0YXS0/YXS-FOC/2312S减速电机BOM表.xlsx

Sheet: 3D打印件
3D打印件
部件类型 | 打印材质(以嘉立创3D打印为例) | 单价(元) | 数量 | 总价(元) | 备注
摆线轮 | 树脂(9600) | 1.90 | 2 | 3.80 | 使用其他材料打印可能出现,无法顺利转动的情况,推荐使用CNC精度更高(3D打印请使用STL格式文件，CNC使用STEP格式文件)
电机输出 | 尼龙(3201PA-F) | 5.50 | 1 | 5.50 | 该部件紧贴电机,电机大力矩输出时发热比较大,故使用耐热性更好的尼龙打印
减速器外壳 | 树脂(9600) | 5.75 | 1 | 5.75
上盖 | 树脂(9600) | 2.71 | 1 | 2.71
输出下轴 | 树脂(9600) | 1.90 | 1 | 1.90
输出轴 | 树脂(9600) | 1.90 | 1 | 1.90 | 最终的承力部件,若希望有更好的机械性能可使用尼龙打印
中心输出轴 | 树脂(9600) | 1.90 | 1 | 1.90
底板 | 尼龙(3201PA-F) | 5.50 | 1 | 5.50 | 该部件和PCB底板二选一即可
总计 |  |  | 9 | 28.96 | 快递费用未计入其中

Sheet: 机械部件
机械部件
部件类型 | 尺寸(mm) | 单价(元) | 数量 | 总价(元) | 购买连接 | 备注
滚珠轴承 | 内8外14厚4 | 1.200 | 1 | 1.200 | http://e.tb.cn/h.gwAezqYSflOik1f?tk=RNxr3Nfsyd5
滚珠轴承 | 内17外23厚4 | 2.000 | 1 | 2.000 | http://e.tb.cn/h.gwAezqYSflOik1f?tk=RNxr3Nfsyd6
滚珠轴承 | 内6外10厚3 | 1.200 | 2 | 2.400 | http://e.tb.cn/h.gwAezqYSflOik1f?tk=RNxr3Nfsyd7
滚珠轴承 | 内20外25厚4 | 6.000 | 1 | 6.000 | http://e.tb.cn/h.gDXFbnwdLOXjEyB?tk=yNgH3NftFau
平面轴承 | 内3外8厚3.5 | 1.450 | 1 | 1.450 | http://e.tb.cn/h.gDAGYxVDCCutdY5?tk=1JH03NfEPaf
预埋螺母 | 内M2外3.2高8 | 0.126 | 3 | 0.378 | http://e.tb.cn/h.gD20d1XfinrMQWy?tk=1Kib3Nfzbb4 | 6.3元50个
预埋螺母 | 内M2.5外3.5高3 | 0.048 | 6 | 0.288 | http://e.tb.cn/h.gwAOoIkBYJf77n9?tk=GZgo3NUYhYO | 1.44元30个
销钉 | M2*12 | 0.038 | 5 | 0.190 | http://e.tb.cn/h.gD2TEVjGOG2dwrO?tk=c1tn3NU5gqG | 1.61元100个
销钉 | M3*10 | 0.070 | 15 | 1.050 | http://e.tb.cn/h.gD2TEVjGOG2dwrO?tk=c1tn3NU6gqG | 1.34元50个
销钉 | M1*14 | 0.032 | 2 | 0.064 | http://e.tb.cn/h.gD2TEVjGOG2dwrO?tk=c1tn3NU7gqG | 1.61元100个
垫片 | M2*6*0.5 | 0.014 | 15 | 0.217 | http://e.tb.cn/h.gxa4c33pDSauiBj?tk=GuPI3NU540g | 2.89元200个
螺丝 | M2.5*20*4.5 | 0.067 | 6 | 0.400 | http://e.tb.cn/h.T2p2wnHFBUwPk0t?tk=4aWF3uRsDdy | 2.24元50个
内六角螺丝 | M3*5*5 | 0.020 | 2 | 0.041 | http://e.tb.cn/h.gwAwCQvNh4fQR93?tk=WvMC3NU8SnZ | 2.03元100个
螺丝 | M2*3*3.2 | 0.012 | 3 | 0.035 | http://e.tb.cn/h.gwAwCQvNh4fQR93?tk=WvMC3NU9SnZ | 1.18元100个
不锈钢衬套 | M3*5*3 | 0.197 | 10 | 1.970 | http://e.tb.cn/h.gxaNdNyyLO7N2vL?tk=Hkxm3NUozhD | 4.94元20个(若摆线轮是CNC则不需要此部件)
尼龙隔离柱 | M3*6*3 | 0.008 | 3 | 0.023 | http://e.tb.cn/h.gD2qf9edzUgIYtY?tk=kwHM3NUoTjZ | 1.54元200个
径向磁铁 | 外径6高4 | 0.880 | 1 | 0.880 | http://e.tb.cn/h.gDaeiyN2f5CzciD?tk=kZVd3NUJHXO | 8.8元10个
无刷电机 | 2312S | 8.360 | 1 | 8.360 | http://e.tb.cn/h.gxaujdSyXChxcuv?tk=2sNl3NUvGHP | 拆机电机,价格会有浮动
电源接口 | XT30U-M公头 | 1.050 | 1 | 1.050 | http://e.tb.cn/h.gx0m8w16t4DXy38?tk=u0sD3Ngnn6M
总计 |  |  |  | 24.795 |  | 快递费用未计入其中

Sheet: 电子元件
No. | Quantity | Comment | Designator | Footprint | Value | Manufacturer Part | Manufacturer | Supplier Part | Supplier | 备注
1 | 3 | 1uF | C1,C2,C3 | C0805 | 1uF | CL21B105KBFNNNE | SAMSUNG(三星) | C28323 | LCSC
2 | 3 | 10uF | C4,C7,C10 | C0603 | 10uF | CL10A106KP8NNNC | SAMSUNG(三星) | C19702 | LCSC
3 | 12 | 100nF | C5,C8,C9,C12,C16,C18,C19,C20,C21,C22,C35,C36 | C0603 | 100nF | 0603B104K500NT | FH(风华) | C30926 | LCSC
4 | 2 | 22pF | C6,C34 | C0603 | 22pF | CC0603JRNPO9BN220 | YAGEO(国巨) | C105620 | LCSC
5 | 2 | 1nF | C11,C15 | C0603 | 1nF | CC0603KRX7R9BB102 | YAGEO(国巨) | C100040 | LCSC
6 | 1 | 10uF | C17 | C0603 | 10uF | CL10A106MA8NRNC | SAMSUNG(三星) | C96446 | LCSC
7 | 4 | 47uF | C27,C28,C29,C30 | C1206 | 47uF | CGA1206X5R476M250NT | HRE(芯声) | C6119973 | LCSC | 电容耐压应大于电源电压12V，立创商城未找到合适器件，以此暂代，请注意自行更换合适的电容
8 | 1 | 22pF | C31 | C0603 | 22pF | CL10C220JB8NNNC | SAMSUNG(三星) | C1653 | LCSC
9 | 1 | WAFER-SH1.0-4PWB | CN2 | CONN-SMD_4P-P1.00_WAFER-SH1.0-4PWB |  | WAFER-SH1.0-4PWB | XUNPU(讯普) | C3029343 | LCSC | SH1.0 4P
10 | 4 | 1N5819WS | D1,D2,D3,D8 | SOD-323_L1.8-W1.3-LS2.5-RD |  | 1N5819WS | Hottech(合科泰) | C191023 | LCSC | 二极管
11 | 1 | ZMM20 | D4 | LL-34_L3.5-W1.5-RD |  | ZMM20 | Slkor(萨科微) | C707208 | LCSC | 20V稳压管
12 | 1 | SMBJ16CA | D7 | SMB_L4.3-W3.6-LS5.4-BI |  | SMBJ16CA | TWGMC(台湾迪嘉) | C726865 | LCSC | 瞬态抑制二极管(TVS)16V
13 | 1 | ZMM3V6 | D9 | LL-34_L3.5-W1.5-RD |  | ZMM3V6 | HXY MOSFET(华轩阳电子) | C5345988 | LCSC | 3.6V稳压管
15 | 1 | 4.7uH | L1 | IND-SMD_L3.0-W3.0_FNR30XXS | 4.7uH | FNR3015S4R7MT | cjiang(长江微电) | C167753 | LCSC | 电感
16 | 1 | SZYY0603R | LED1 | LED0603-R-RD |  | SZYY0603R | yongyu(永裕光电) | C434419 | LCSC | 发光二极管 0603封装
18 | 6 | AON7544 | Q1,Q2,Q3,Q4,Q5,Q6 | DFN-8_L3.3-W3.3-P0.65-BL-2 |  | AON7544 | AOS | C315567 | LCSC | MOS管 30V100A (此mos似乎只有立创商城有卖,淘宝相同封装的只有峰值30A,但无论使用哪种都行,不影响功能)
19 | 6 | 10Ω | R1,R2,R3,R7,R8,R9 | R0603 | 10Ω | 0603WAF100JT5E | UNI-ROYAL(厚声) | C22859 | LCSC
20 | 14 | 10kΩ | R4,R5,R6,R10,R11,R12,R19,R27,R28,R30,R32,R33,R35,R36 | R0603 | 10kΩ | 0603WAF1002T5E | UNI-ROYAL(厚声) | C25804 | LCSC
21 | 2 | 5mΩ | R15,R17 | R0805 | 5mΩ | PE0805FRF470R005Z | YAGEO(国巨) | C5198288 | LCSC | 采样电阻 5mR 0805
22 | 1 | 100kΩ | R18 | R0603 | 100kΩ | 0603WAF1003T5E | UNI-ROYAL(厚声) | C25803 | LCSC
23 | 3 | 120Ω | R21,R23,R26 | R0603 | 120Ω | 0603WAF1200T5E | UNI-ROYAL(厚声) | C22787 | LCSC
24 | 1 | 51kΩ | R24 | R0805 | 51kΩ | 0805W8F5102T5E | UNI-ROYAL(厚声) | C17737 | LCSC
25 | 1 | 2.2kΩ | R29 | R0603 | 2.2kΩ | FRC0603J222 TS | FOJAN(富捷) | C2907117 | LCSC
26 | 1 | CMFA103J3950HANT | R34 | R0603 |  | CMFA103J3950HANT | FH(风华) | C338606 | LCSC | 3950温敏电阻
27 | 1 | MK-12C02-G020 | SW3 | SW-SMD_MK-12C02-G020 |  | MK-12C02-G020 | G-Switch(品赞) | C963206 | LCSC | 拨动开关 贴片 两档7脚
28 | 1 | FD6288T | U1 | TSSOP-20_L6.5-W4.4-P0.65-LS6.4-BL |  | FD6288T | Fortior Tech(峰岹) | C97683 | LCSC | MOS驱动芯片
29 | 1 | PW2162 | U2 | SOT-23-6_L2.9-W1.6-P0.95-LS2.8-BL |  | PW2162 |  | C9900006107 | LCSC | DCDC降压芯片
30 | 2 | INA181A1IDBVR | U4,U6 | SOT-23-6_L2.9-W1.6-P0.95-LS2.8-TL |  | INA181A1IDBVR | TI(德州仪器) | C2058943 | LCSC | 采样芯片
31 | 1 | PW6206-3.3 | U7 | SOT-23-3_L2.9-W1.6-P1.90-LS2.8-BR |  | PW6206-3.3 |  | C2836883 | LCSC | 3.3VLDO
32 | 1 | SN65HVD232DR | U8 | SOIC-8_L5.0-W4.0-P1.27-LS6.0-BL |  | SN65HVD232DR | TI(德州仪器) | C30530 | LCSC | CAN收发器
33 | 1 | GD32F303CCT6 | U9 | LQFP-48_L7.0-W7.0-P0.50-LS9.0-BL |  | GD32F303CCT6 | GigaDevice(兆易创新) | C116151 | LCSC | 单片机
34 | 1 | AS5047P-ATSM | U10 | TSSOP-14_L5.0-W4.4-P0.65-LS6.4-BL |  | AS5047P-ATSM | ams(艾迈斯半导体) | C962063 | LCSC | 编码器 SPI
35 | 1 | WAFER-SH1.0-2PWB | U12 | CONN-SMD_2P-P1.00_XUNPU_WAFER-SH1.0-2PWB |  | WAFER-SH1.0-2PWB | XUNPU(讯普) | C3029341 | LCSC | SH1.0 2P
37 | 1 | SMD0805B050TF | U14 | F0805 |  | SMD0805B050TF | Brightking(君耀电子) | C269104 | LCSC | 自恢复保险丝500mA 0805
38 | 1 | 8MHz | X1 | OSC-SMD_4P-L3.2-W2.5-BL | 8MHz | X32258MOB4SI | YXC(扬兴晶振) | C2682775 | LCSC | 晶振
以上器件都是以立创商城为例,可自行到购物软件上寻找封装和值相对应的器件

Sheet: PCB板
PCB板
类型 | 层数 | 作用
驱动板 | 4 | 电机驱动核心板
PCB底板 | 1 | 作为减速器外壳的底板使用,与3D打印底板2选一即可
