0YXS0/YXS-FOC/FWLib/Include/gd32f30x_timer.h

/*!
    \file    gd32f30x_timer.h
    \brief   definitions for the TIMER
    
    \version 2023-12-30, V2.2.0, firmware for GD32F30x
*/

/*
    Copyright (c) 2020, GigaDevice Semiconductor Inc.

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
    1. Redistributions of source code must retain the above copyright notice, this 
       list of conditions and the following disclaimer.
    2. Redistributions in binary form must reproduce the above copyright notice, 
       this list of conditions and the following disclaimer in the documentation 
       and/or other materials provided with the distribution.
    3. Neither the name of the copyright holder nor the names of its contributors 
       may be used to endorse or promote products derived from this software without 
       specific prior written permission.

    THIS SOFTWARE IS PROVIDED BY THE COPYRIGHT HOLDERS AND CONTRIBUTORS "AS IS" 
AND ANY EXPRESS OR IMPLIED WARRANTIES, INCLUDING, BUT NOT LIMITED TO, THE IMPLIED 
WARRANTIES OF MERCHANTABILITY AND FITNESS FOR A PARTICULAR PURPOSE ARE DISCLAIMED. 
IN NO EVENT SHALL THE COPYRIGHT HOLDER OR CONTRIBUTORS BE LIABLE FOR ANY DIRECT, 
INDIRECT, INCIDENTAL, SPECIAL, EXEMPLARY, OR CONSEQUENTIAL DAMAGES (INCLUDING, BUT 
NOT LIMITED TO, PROCUREMENT OF SUBSTITUTE GOODS OR SERVICES; LOSS OF USE, DATA, OR 
PROFITS; OR BUSINESS INTERRUPTION) HOWEVER CAUSED AND ON ANY THEORY OF LIABILITY, 
WHETHER IN CONTRACT, STRICT LIABILITY, OR TORT (INCLUDING NEGLIGENCE OR OTHERWISE) 
ARISING IN ANY WAY OUT OF THE USE OF THIS SOFTWARE, EVEN IF ADVISED OF THE POSSIBILITY 
OF SUCH DAMAGE.
*/

#ifndef GD32F30X_TIMER_H
#define GD32F30X_TIMER_H

#include "gd32f30x.h"

/* TIMERx(x=0..13) definitions */
#define TIMER0                           (TIMER_BASE + 0x00012C00U)
#define TIMER1                           (TIMER_BASE + 0x00000000U)
#define TIMER2                           (TIMER_BASE + 0x00000400U)
#define TIMER3                           (TIMER_BASE + 0x00000800U)
#define TIMER4                           (TIMER_BASE + 0x00000C00U)
#define TIMER5                           (TIMER_BASE + 0x00001000U)
#define TIMER6                           (TIMER_BASE + 0x00001400U)
#define TIMER7                           (TIMER_BASE + 0x00013400U)
#define TIMER8                           (TIMER_BASE + 0x00014C00U)
#define TIMER9                           (TIMER_BASE + 0x00015000U)
#define TIMER10                          (TIMER_BASE + 0x00015400U)
#define TIMER11                          (TIMER_BASE + 0x00001800U)
#define TIMER12                          (TIMER_BASE + 0x00001C00U)
#define TIMER13                          (TIMER_BASE + 0x00002000U)

/* registers definitions */
#define TIMER_CTL0(timerx)               REG32((timerx) + 0x00U)           /*!< TIMER control register 0 */
#define TIMER_CTL1(timerx)               REG32((timerx) + 0x04U)           /*!< TIMER control register 1 */
#define TIMER_SMCFG(timerx)              REG32((timerx) + 0x08U)           /*!< TIMER slave mode configuration register */
#define TIMER_DMAINTEN(timerx)           REG32((timerx) + 0x0CU)           /*!< TIMER DMA and interrupt enable register */
#define TIMER_INTF(timerx)               REG32((timerx) + 0x10U)           /*!< TIMER interrupt flag register */
#define TIMER_SWEVG(timerx)              REG32((timerx) + 0x14U)           /*!< TIMER software event generation register */
#define TIMER_CHCTL0(timerx)             REG32((timerx) + 0x18U)           /*!< TIMER channel control register 0 */
#define TIMER_CHCTL1(timerx)             REG32((timerx) + 0x1CU)           /*!< TIMER channel control register 1 */
#define TIMER_CHCTL2(timerx)             REG32((timerx) + 0x20U)           /*!< TIMER channel control register 2 */
#define TIMER_CNT(timerx)                REG32((timerx) + 0x24U)           /*!< TIMER counter register */
#define TIMER_PSC(timerx)                REG32((timerx) + 0x28U)           /*!< TIMER prescaler register */
#define TIMER_CAR(timerx)                REG32((timerx) + 0x2CU)           /*!< TIMER counter auto reload register */
#define TIMER_CREP(timerx)               REG32((timerx) + 0x30U)           /*!< TIMER counter repetition register */
#define TIMER_CH0CV(timerx)              REG32((timerx) + 0x34U)           /*!< TIMER channel 0 capture/compare value register */
#define TIMER_CH1CV(timerx)              REG32((timerx) + 0x38U)           /*!< TIMER channel 1 capture/compare value register */
#define TIMER_CH2CV(timerx)              REG32((timerx) + 0x3CU)           /*!< TIMER channel 2 capture/compare value register */
#define TIMER_CH3CV(timerx)              REG32((timerx) + 0x40U)           /*!< TIMER channel 3 capture/compare value register */
#define TIMER_CCHP(timerx)               REG32((timerx) + 0x44U)           /*!< TIMER complementary channel protection register */
#define TIMER_DMACFG(timerx)             REG32((timerx) + 0x48U)           /*!< TIMER DMA configuration register */
#define TIMER_DMATB(timerx)              REG32((timerx) + 0x4CU)           /*!< TIMER DMA transfer buffer register */
#define TIMER_IRMP(timerx)               REG32((timerx) + 0x50U)           /*!< TIMER channel input remap register */
#define TIMER_CFG(timerx)                REG32((timerx) + 0xFCU)           /*!< TIMER configuration register */

/* bits definitions */
/* TIMER_CTL0 */
#define TIMER_CTL0_CEN                   BIT(0)              /*!< TIMER counter enable */
#define TIMER_CTL0_UPDIS                 BIT(1)              /*!< update disable */
#define TIMER_CTL0_UPS                   BIT(2)              /*!< update source */
#define TIMER_CTL0_SPM                   BIT(3)              /*!< single pulse mode */
#define TIMER_CTL0_DIR                   BIT(4)              /*!< timer counter direction */
#define TIMER_CTL0_CAM                   BITS(5,6)           /*!< center-aligned mode selection */
#define TIMER_CTL0_ARSE                  BIT(7)              /*!< auto-reload shadow enable */
#define TIMER_CTL0_CKDIV                 BITS(8,9)           /*!< clock division */
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
