0YXS0/YXS-FOC/(commit log)

2024-10-04 完善校准功能、添加Flash操作
2024-10-05 初步实现闭环
2024-10-12 增加抗齿槽力矩补偿功能
2024-10-12 增加数据检查和错误检测机制
2024-10-16 改写ADC采样逻辑
2024-10-18 完善补偿功能和闭环控制
2024-10-21 1、增加SPI功能和AS5047P编码器的使用 2、增加模式切换函数和完善错误处理机制
2024-10-27 初步完成减速器的适配
2024-11-24 修改目录结构
    [2312S减速电机BOM表.xlsx, YXS-FOC：CAN通信协议.xlsx]
2024-11-24 增加CAN通信功能
    [YXS-FOC：CAN通信协议.xlsx]
2024-11-25 完善减速器的适配
    [YXS-FOC：CAN通信协议.xlsx]
2024-12-01 完善文档内容
    [2312S减速电机BOM表.xlsx, YXS-FOC：CAN通信协议.xlsx]
2024-12-08 添加串口通信协议说明手册
2024-12-23 上传减速器组装步骤
